zaitldav/AutoGardener/Prototype/Hardware/Gerbers/README - Plan_monitoring_devide_layer_description.txt

Plant_monitoring_device-F.SilkS.gbr                 Top Silk Screen
Plant_monitoring_device-F.Mask.gbr                  Top Solder Mask
Plant_monitoring_device-F.Cu.gbr                    Top Copper
Plant_monitoring_device-B.Cu.gbr                    Bottom Copper
Plant_monitoring_device-B.Mask.gbr                  Bottom Solder Mask
Plant_monitoring_device-B.SilkS.gbr                 Bottom Silk Screen
Plant_monitoring_device-Edge.Cuts.gbr               Board Outline
Plant_monitoring_device-PTH.drl                     Plated Drill
Plant_monitoring_device-NPTH.drl                    Non Plated Drill
