zaitldav/AutoGardener/Box/bottom.obj

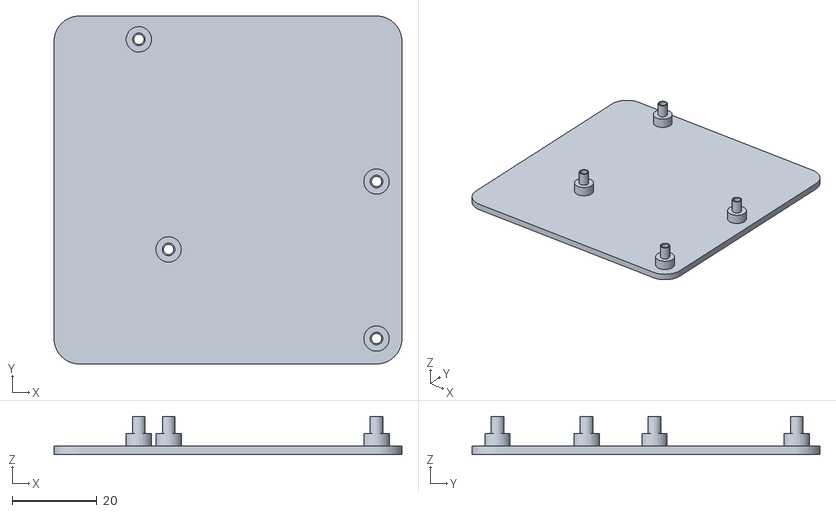
[picture p1: CAD file, 2019-11-17]
Box/bottom.obj
82.0 x 82.0 x 9.00
