zaitldav/AutoGardener/Indoor_Version/Box/Sensor_box.fcstd

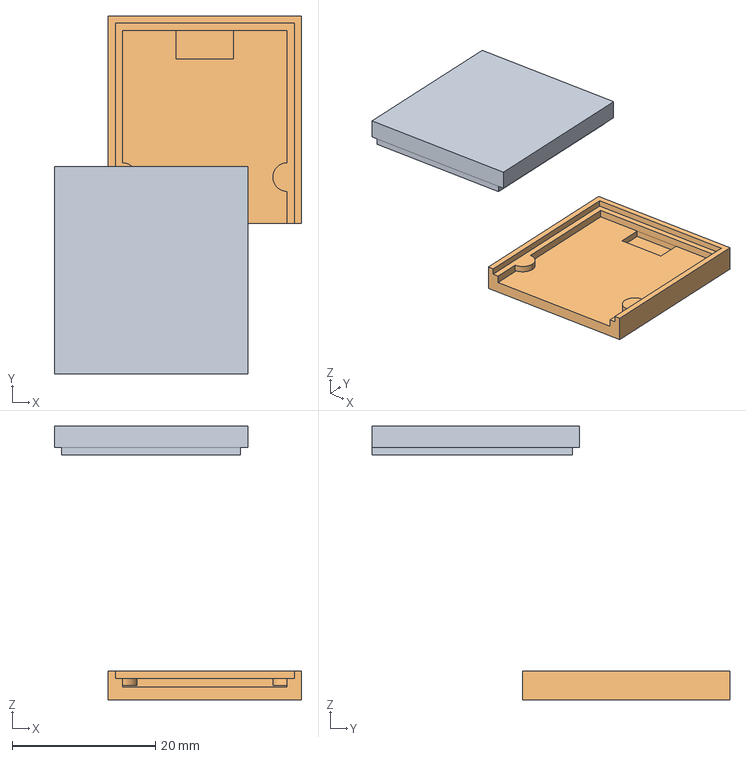
[picture p2: CAD file, 2019-05-28]
Indoor_Version/Box/Sensor_box.fcstd
34.5 x 50.0 x 38.2 mm
Box_top
Box_bot
