zaitldav/AutoGardener/Indoor_Version/Box/STL/Sensor_Box_Bot.stl

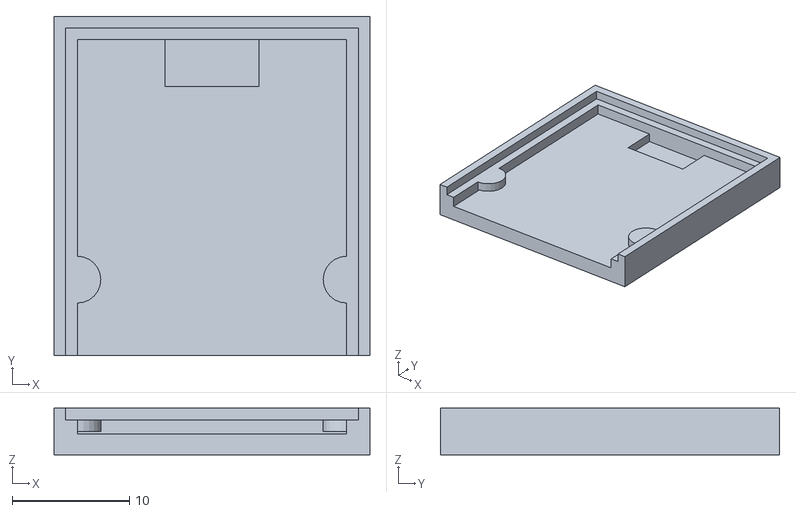
[picture p3: CAD file, 2019-05-28]
Indoor_Version/Box/STL/Sensor_Box_Bot.stl
27.0 x 29.0 x 4.00
