zaitldav/AutoGardener/Indoor_Version/Hardware/Plant_monitoring_device.step

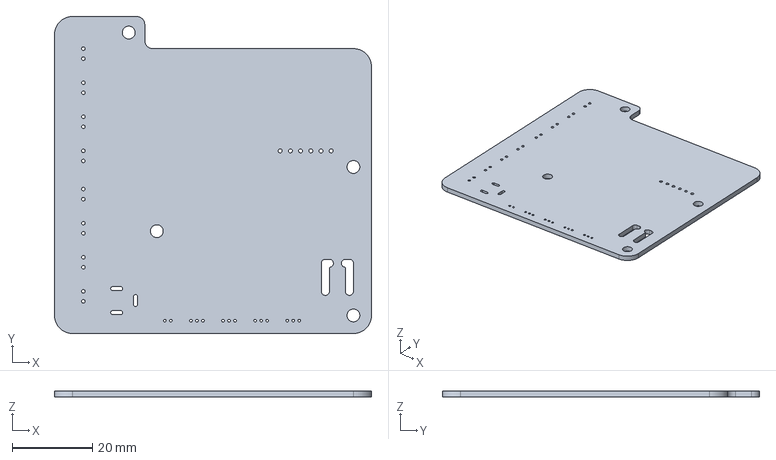
[picture p4: CAD file, 2019-08-13]
Indoor_Version/Hardware/Plant_monitoring_device.step
79.0 x 79.0 x 1.60 mm
