zaitldav/AutoGardener/Box/auto_gardener_top.obj

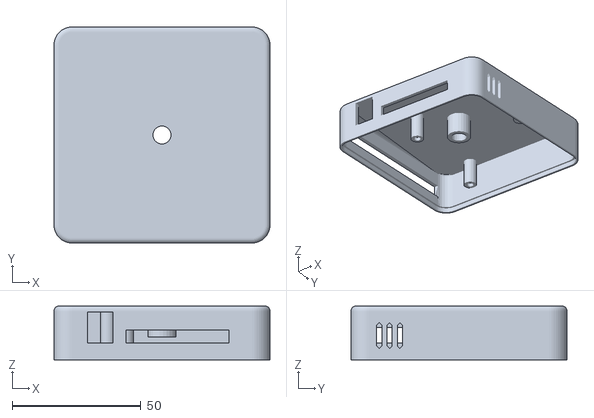
[picture p5: CAD file, 2019-11-17]
Box/auto_gardener_top.obj
84.0 x 84.0 x 21.0
