zaitldav/AutoGardener/Indoor_Version/Box/Box_drawing.dxf

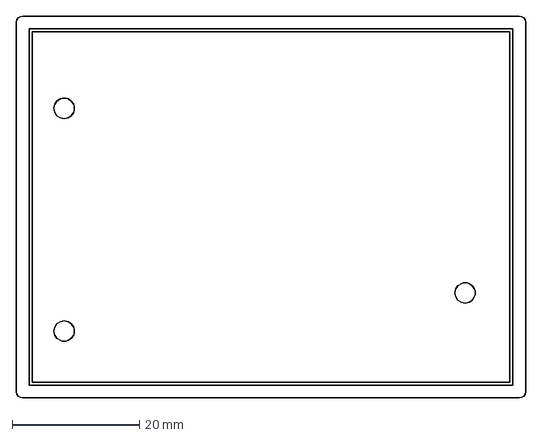
[picture p6: CAD file, 2019-05-14]
Indoor_Version/Box/Box_drawing.dxf
80.0 x 60.0 mm
