zaitldav/AutoGardener/Prototype/Box/Box_v1.fcstd

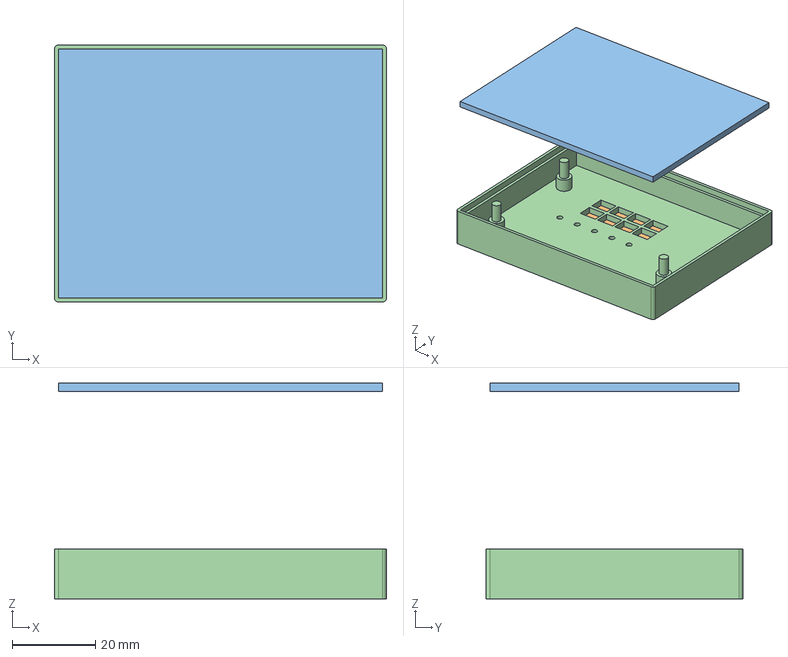
[picture p7: CAD file, 2019-05-14]
Prototype/Box/Box_v1.fcstd
80.0 x 62.0 x 52.0 mm
Inside_Face
Outside_Face
Lid
