zaitldav/AutoGardener/Box/autogardener_box.FCStd

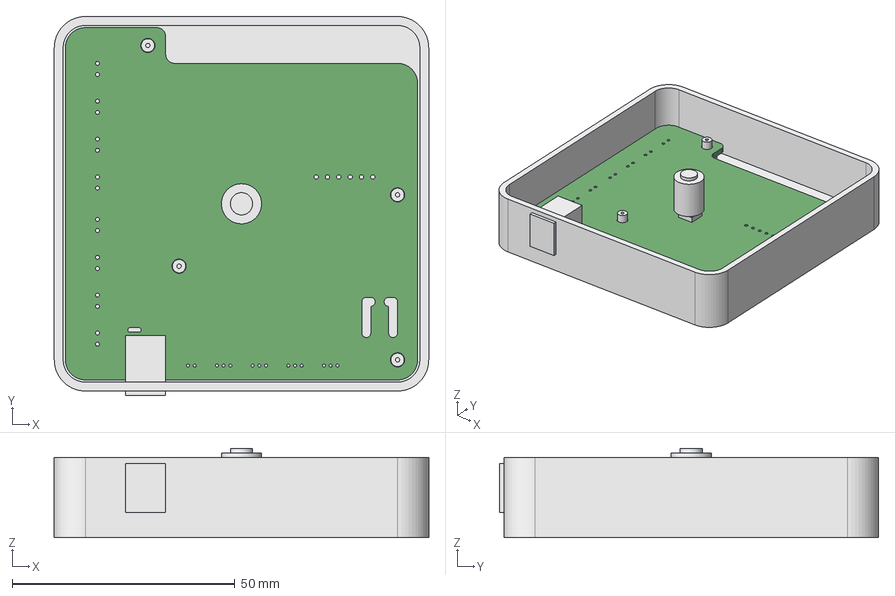
[picture p8: CAD file, 2019-08-13]
Box/autogardener_box.FCStd
84.0 x 85.0 x 20.0 mm
Bottom
Side
Bottom_pillar001
Bottom_pillar002
Bottom_pillar003
Bottom_pillar004
LED_Pilllar_Outside
LED_Pillar_Inside
Power_Connector
