zaitldav/AutoGardener/(list of files, cad)

Other CAD files:
Indoor_Version/Box/STL/Sensor_Box_Top.stl
Outdoor_Version/Box/STL/Sensor_Box_Top.stl
Prototype/Box/STL/Sensor_Box_Top.stl
Box/auto_gardener_bottom.obj
