zaitldav/AutoGardener/(threads)

Thread 1 (2019-04-08):

Select LDO

zaitldav, 2019-04-08:
Select a LDO: Vinmax > 12V, Iout max > 50mA; Iq as low as possible, Price < 20CZK

 * [LD2985BM33R](https://www.tme.eu/cz/details/ld2985bm33r/stabilizatory-napeti-neregulovane-ldo/st-microelectronics/) - Iq = 80-100 uA; I50 = 600-900 uA; 10CZK
 * [**IFX1763XEJV33XUMA1**](https://www.tme.eu/cz/details/ifx1763xejv33/stabilizatory-napeti-neregulovane-ldo/infineon-technologies/ifx1763xejv33xuma1/) - Iq = 30-60 uA; I50 = 300-850 uA; 18CZK
 * [**SPX5205M5-L-3-3/TR**](https://www.tme.eu/cz/details/spx5205m5l3-3tr/stabilizatory-napeti-neregulovane-ldo/exar/spx5205m5-l-3-3-tr/) - Iq = 70-130-100 uA; I50 = 350-800 uA; 7CZK
 * [**AP2204RB-3.3TRG1**](https://www.tme.eu/cz/details/ap2204rb-3.3trg1/stabilizatory-napeti-neregulovane-ldo/diodes-incorporated/)  - Iq = 20-50 uA; I50 = 500 uA; 4.25CZK
 * [MIC5205-3.3YM5-TR](https://www.tme.eu/cz/details/mic5205-3.3ym5-tr/stabilizatory-napeti-neregulovane-ldo/microchip-technology/)  - Iq = 80-150 uA; I50 = 350-800 uA; 12.25CZK

zaitldav, 2019-04-09:
Done - SPX5205M5-L-3-3/TR

Closed 2019-04-09.

Thread 2 (2019-05-28):

Think about future versions

zaitldav, 2019-05-28:
There will be at least two versions in the future:
 * Indoor wired version with LED strips and valves/pumps.
    * How many channels?
    * Use USB communication (STM32) or wifi (ESP32)
    * Add a light sensor.
 * Outdoor battery-powered version with valves only.
    * Use batteries with higher voltage, 3V is not enough for valves. Use at least 3xAA/AAA.
    * LoRa communication?
    * Maybe more versions, the communicating one should measure temperature and humidity.

Closed 2019-07-19.

Thread 3 (2019-05-28):

Select another power connector

zaitldav, 2019-05-28:
Select a power connector for DC power supply which is smaller than the recent one.

The used 5.5/2.5 barrel jack is too high, something 1-2mm shorter than the connectors should be used.

zaitldav, 2019-07-19:
Not needed in this design.

Closed 2019-07-19.
