zaitldav/AutoGardener/Indoor_Version/Hardware/Plant_monitoring_device.kicad_pcb

## KiCad design Indoor_Version/Hardware/Plant_monitoring_device.kicad_pcb (2019-11-17)

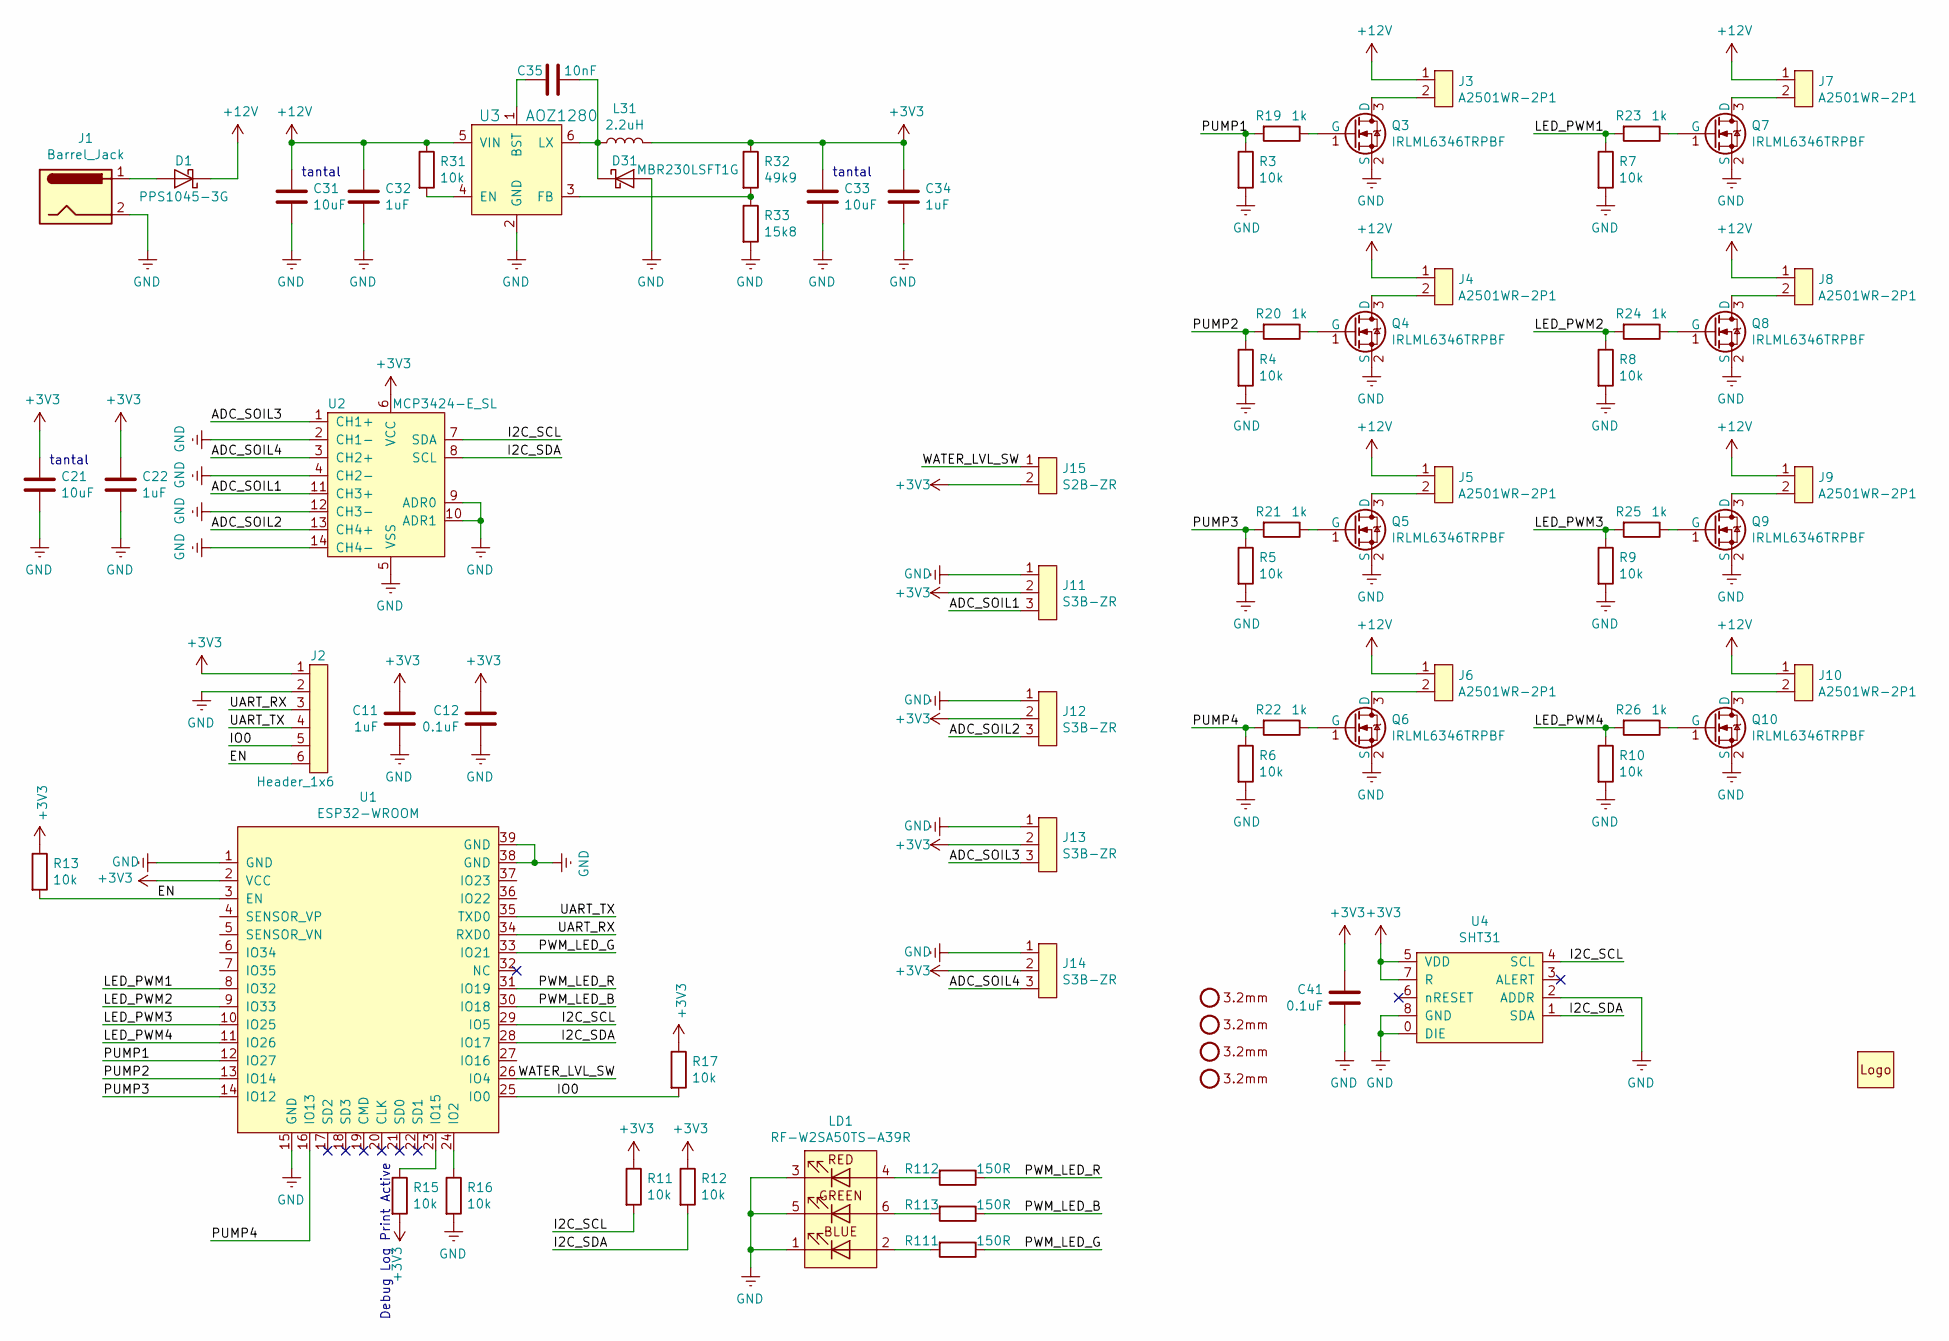
[picture p9: schematic Plant_monitoring_device.sch, Plant Monitoring Device]

Parts:
C11, C22, C32, C34: 1uF; C0603
C12, C41: 0.1uF; C0603
C21, C31, C33: 10uF; C1210
C35: 10nF; C0603
D1: PPS1045-3G; TO-277-3
D31: MBR230LSFT1G; SOD-123
H1, H2, H3, H4: Mounting_hole_unplated_3,2mm
H111: Mr_Gardener_Logo_Small; mrg_gardener_12mm
J1: Barrel_Jack; BarrelJack_Horizontal
J2: Header_1x6; Header_1x06_P2.54mm
J3, J4, J5, J6, J7, J8, J9, J10: A2501WR-2P1
J11, J12, J13, J14: S3B-ZR
J15: S2B-ZR
L31: 2.2uH; L1210
LD1: RF-W2SA50TS-A39R
Q3, Q4, Q5, Q6, Q7, Q8, Q9, Q10: IRLML6346TRPBF; SOT-23
R3, R4, R5, R6, R7, R8, R9, R10, R11, R12, R13, R15, R16, R17, R31: 10k; R0603
R19, R20, R21, R22, R23, R24, R25, R26: 1k; R0603
R32: 49k9; R0603
R33: 15k8; R0603
R111, R112, R113: 150R; R0603
U1: ESP32-WROOM
U2: MCP3424-E_SL; SOIC-14
U3: AOZ1280; SOT-23-6
U4: SHT31

Connections:
+3V3: C11.1, C12.1, C21.1, C22.1, C33.1, C34.1, C41.1, J2.1, J11.2, J12.2, J13.2, J14.2, J15.2, L31.2, R11.1, R12.1, R13.1, R15.2, R17.1, R32.1, U1.2 (VCC), U2.6 (VCC), U4.5 (VDD), U4.7 (R)
+12V: C31.1, C32.1, D1.1 (K), J3.1, J4.1, J5.1, J6.1, J7.1, J8.1, J9.1, J10.1, R31.1, U3.5 (VIN)
/ADC_SOIL1: J11.3, U2.11 (CH3+)
/ADC_SOIL2: J12.3, U2.13 (CH4+)
/ADC_SOIL3: J13.3, U2.1 (CH1+)
/ADC_SOIL4: J14.3, U2.3 (CH2+)
/EN: J2.6, R13.2, U1.3 (EN)
/I2C_SCL: R11.2, U1.29 (IO5), U2.7 (SDA), U4.4 (SCL)
/I2C_SDA: R12.2, U1.28 (IO17), U2.8 (SCL), U4.1 (SDA)
/IO0: J2.5, R17.2, U1.25 (IO0)
/LED_PWM1: R7.1, R23.2, U1.8 (IO32)
/LED_PWM2: R8.1, R24.2, U1.9 (IO33)
/LED_PWM3: R9.1, R25.2, U1.10 (IO25)
/LED_PWM4: R10.1, R26.2, U1.11 (IO26)
/PUMP1: R3.1, R19.2, U1.12 (IO27)
/PUMP2: R4.1, R20.2, U1.13 (IO14)
/PUMP3: R5.1, R21.2, U1.14 (IO12)
/PUMP4: R6.1, R22.2, U1.16 (IO13)
/PWM_LED_B: R113.1, U1.30 (IO18)
/PWM_LED_G: R111.1, U1.33 (IO21)
/PWM_LED_R: R112.1, U1.31 (IO19)
/UART_RX: J2.3, U1.34 (RXD0)
/UART_TX: J2.4, U1.35 (TXD0)
/WATER_LVL_SW: J15.1, U1.26 (IO4)
GND: C11.2, C12.2, C21.2, C22.2, C31.2, C32.2, C33.2, C34.2, C41.2, D31.2 (A), J1.2, J2.2, J11.1, J12.1, J13.1, J14.1, LD1.1 (K), LD1.3 (K), LD1.5 (K), Q3.2 (S), Q4.2 (S), Q5.2 (S), Q6.2 (S), Q7.2 (S), Q8.2 (S), Q9.2 (S), Q10.2 (S), R3.2, R4.2, R5.2, R6.2, R7.2, R8.2, R9.2, R10.2, R16.2, R33.2, U1.1 (GND), U1.15 (GND), U1.38 (GND), U1.39 (GND), U2.2 (CH1-), U2.4 (CH2-), U2.5 (VSS), U2.9 (ADR0), U2.10 (ADR1), U2.12 (CH3-), U2.14 (CH4-), U3.2 (GND), U4.0 (DIE), U4.2 (ADDR), U4.8 (GND)
unnamed: C35.1, U3.1 (BST)
unnamed: C35.2, D31.1 (K), L31.1, U3.6 (LX)
unnamed: D1.2 (A), J1.1
unnamed: J3.2, Q3.3 (D)
unnamed: J4.2, Q4.3 (D)
unnamed: J5.2, Q5.3 (D)
unnamed: J6.2, Q6.3 (D)
unnamed: J7.2, Q7.3 (D)
unnamed: J8.2, Q8.3 (D)
unnamed: J9.2, Q9.3 (D)
unnamed: J10.2, Q10.3 (D)
unnamed: LD1.2 (A), R111.2
unnamed: LD1.4 (A), R112.2
unnamed: LD1.6 (A), R113.2
unnamed: Q3.1 (G), R19.1
unnamed: Q4.1 (G), R20.1
unnamed: Q5.1 (G), R21.1
unnamed: Q6.1 (G), R22.1
unnamed: Q7.1 (G), R23.1
unnamed: Q8.1 (G), R24.1
unnamed: Q9.1 (G), R25.1
unnamed: Q10.1 (G), R26.1
unnamed: R15.1, U1.23 (IO15)
unnamed: R16.1, U1.24 (IO2)
unnamed: R31.2, U3.4 (EN)
unnamed: R32.2, R33.1, U3.3 (FB)

Notes on the sheet:
tantal
Debug Log Print Active

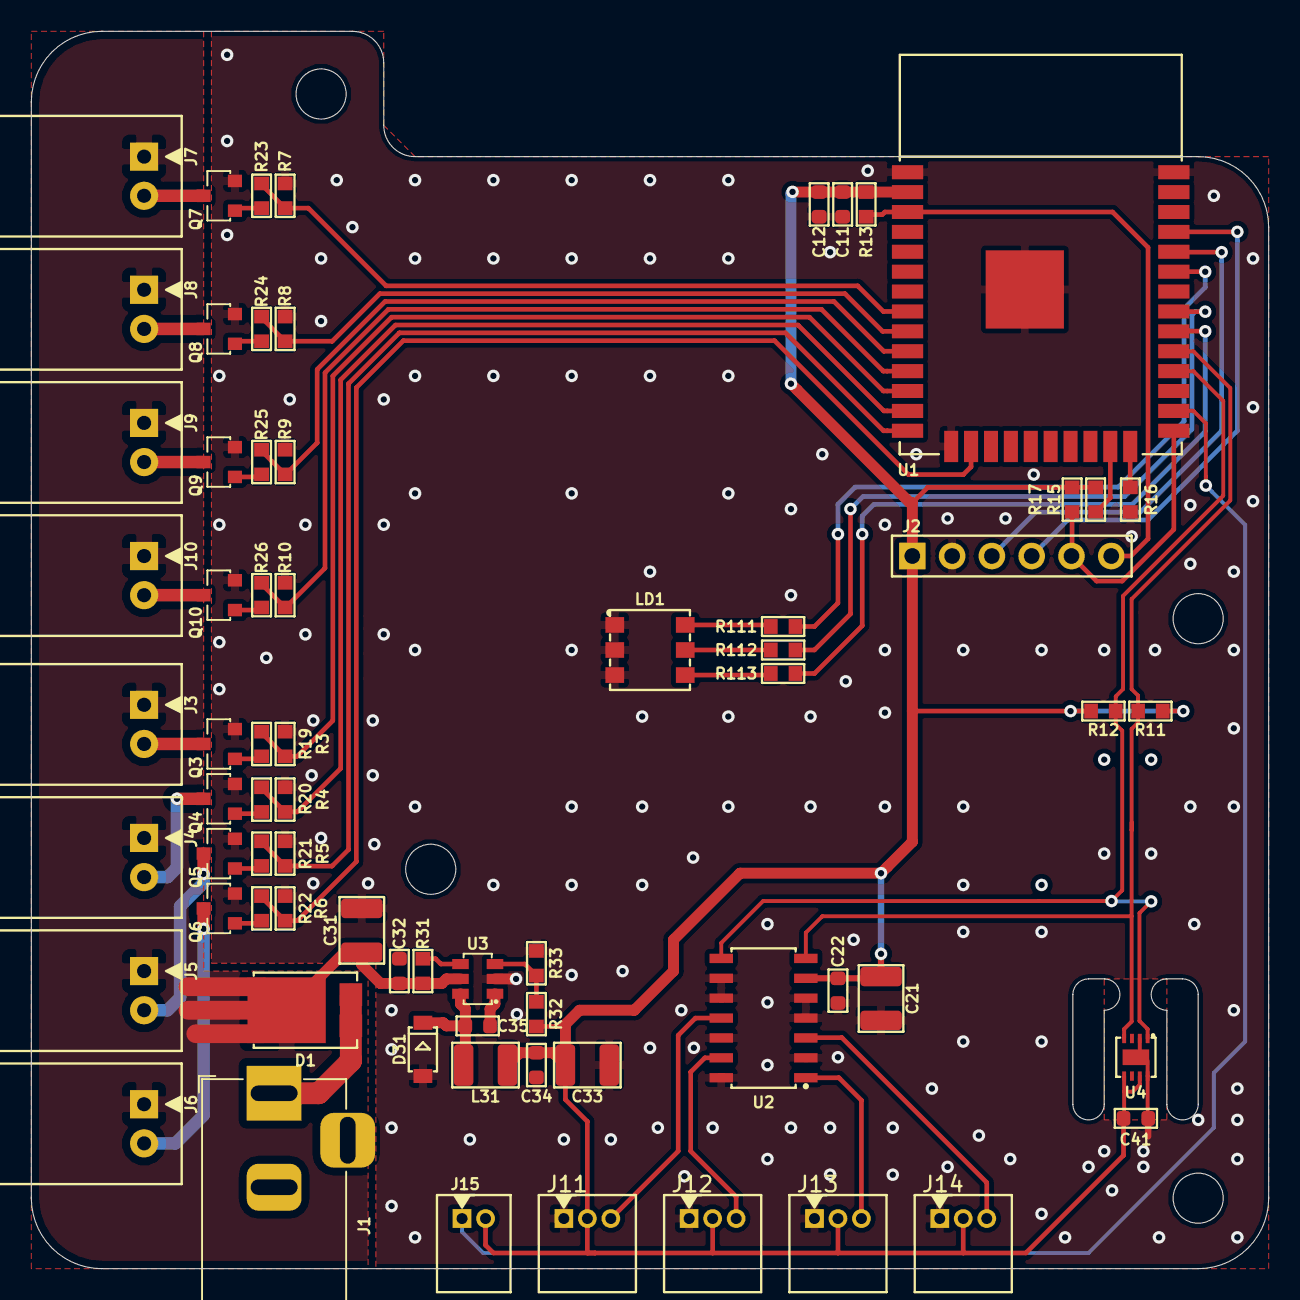
[picture p10: board Indoor_Version/Hardware/Plant_monitoring_device.kicad_pcb from above]

Board: 2 copper layers, 79.0 x 79.0 mm, 74 parts (1 on the bottom side), 51 nets.
