zaitldav/AutoGardener/Outdoor_Version/Hardware/AutoGardener_Outdoor.kicad_pcb

## KiCad design Outdoor_Version/Hardware/AutoGardener_Outdoor.kicad_pcb (2019-08-13)

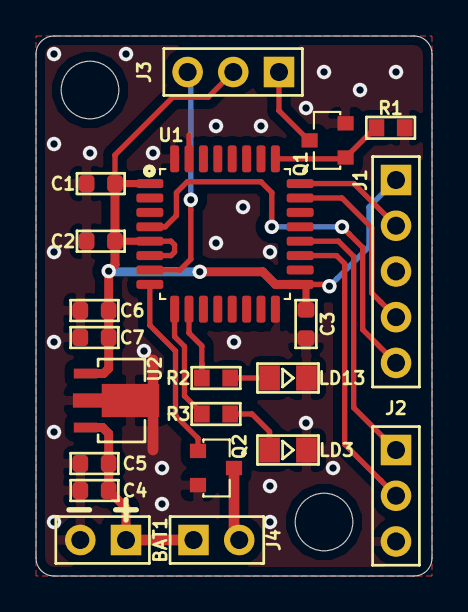
[picture p11: board AutoGardener_Outdoor.kicad_pcb from above]

Board: 2 copper layers, 22.0 x 30.0 mm, 24 parts (1 on the bottom side), 17 nets.

Parts:
BAT1: Battery; Header_1x02_P2.54mm
C1, C5, C7: 1uF; C0603
C2, C3: 0.1uF; C0603
C4, C6: 10uF; C0603
H1, H2: Mounting_hole_unplated_3,2mm
H111: Mr_Gardener_Logo_Small; mrg_gardener_08mm
J1: SWO; Header_1x05_P2.54mm
J2, J3: Header_1x3; Header_1x03_P2.54mm
J4: Header_1x2; Header_1x02_P2.54mm
LD3: ORANGE; LED_0805
LD13: RED; LED_0805
Q1, Q2: 2N7002P.215; SOT-23
R1: 10k; R0603
R2, R3: 1k; R0603
U1: STM32L031K6T6; LQFP-32_7x7mm_P0.8mm
U2: AP2204RB-3.3TRG1; SOT-89

Connections:
+5V: BAT1.1, C4.1, C5.1, J4.1, U2.3
/ADC_SOIL1: J3.3, U1.7
/BAT_LO: R2.1, U1.10
/LED1: R3.1, U1.9
/NRST: J1.5, U1.4
/OUT1: Q2.1, U1.8
/SENS_ENA: Q1.1, R1.1, U1.25
/SWCLK: J1.2, U1.24
/SWDIO: J1.4, U1.23
/UART_RX: J2.1, U1.20
/UART_TX: J2.2, U1.19
GND: BAT1.2, C1.2, C2.2, C3.2, C4.2, C5.2, C6.2, C7.2, J1.3, J2.3, LD3.1, LD13.1, Q1.2, Q2.2, R1.2, U1.16, U1.31, U1.32, U2.2
unnamed: J3.1, Q1.3
unnamed: J4.2, Q2.3
unnamed: LD3.2, R3.2
unnamed: LD13.2, R2.2
VCC: C1.1, C2.1, C3.1, C6.1, C7.1, J1.1, J3.2, U1.1, U1.5, U1.6, U1.17, U2.1
