zaitldav/AutoGardener/Prototype/Hardware/Plant_monitoring_device.kicad_pcb

## KiCad design Prototype/Hardware/Plant_monitoring_device.kicad_pcb (2019-05-14)

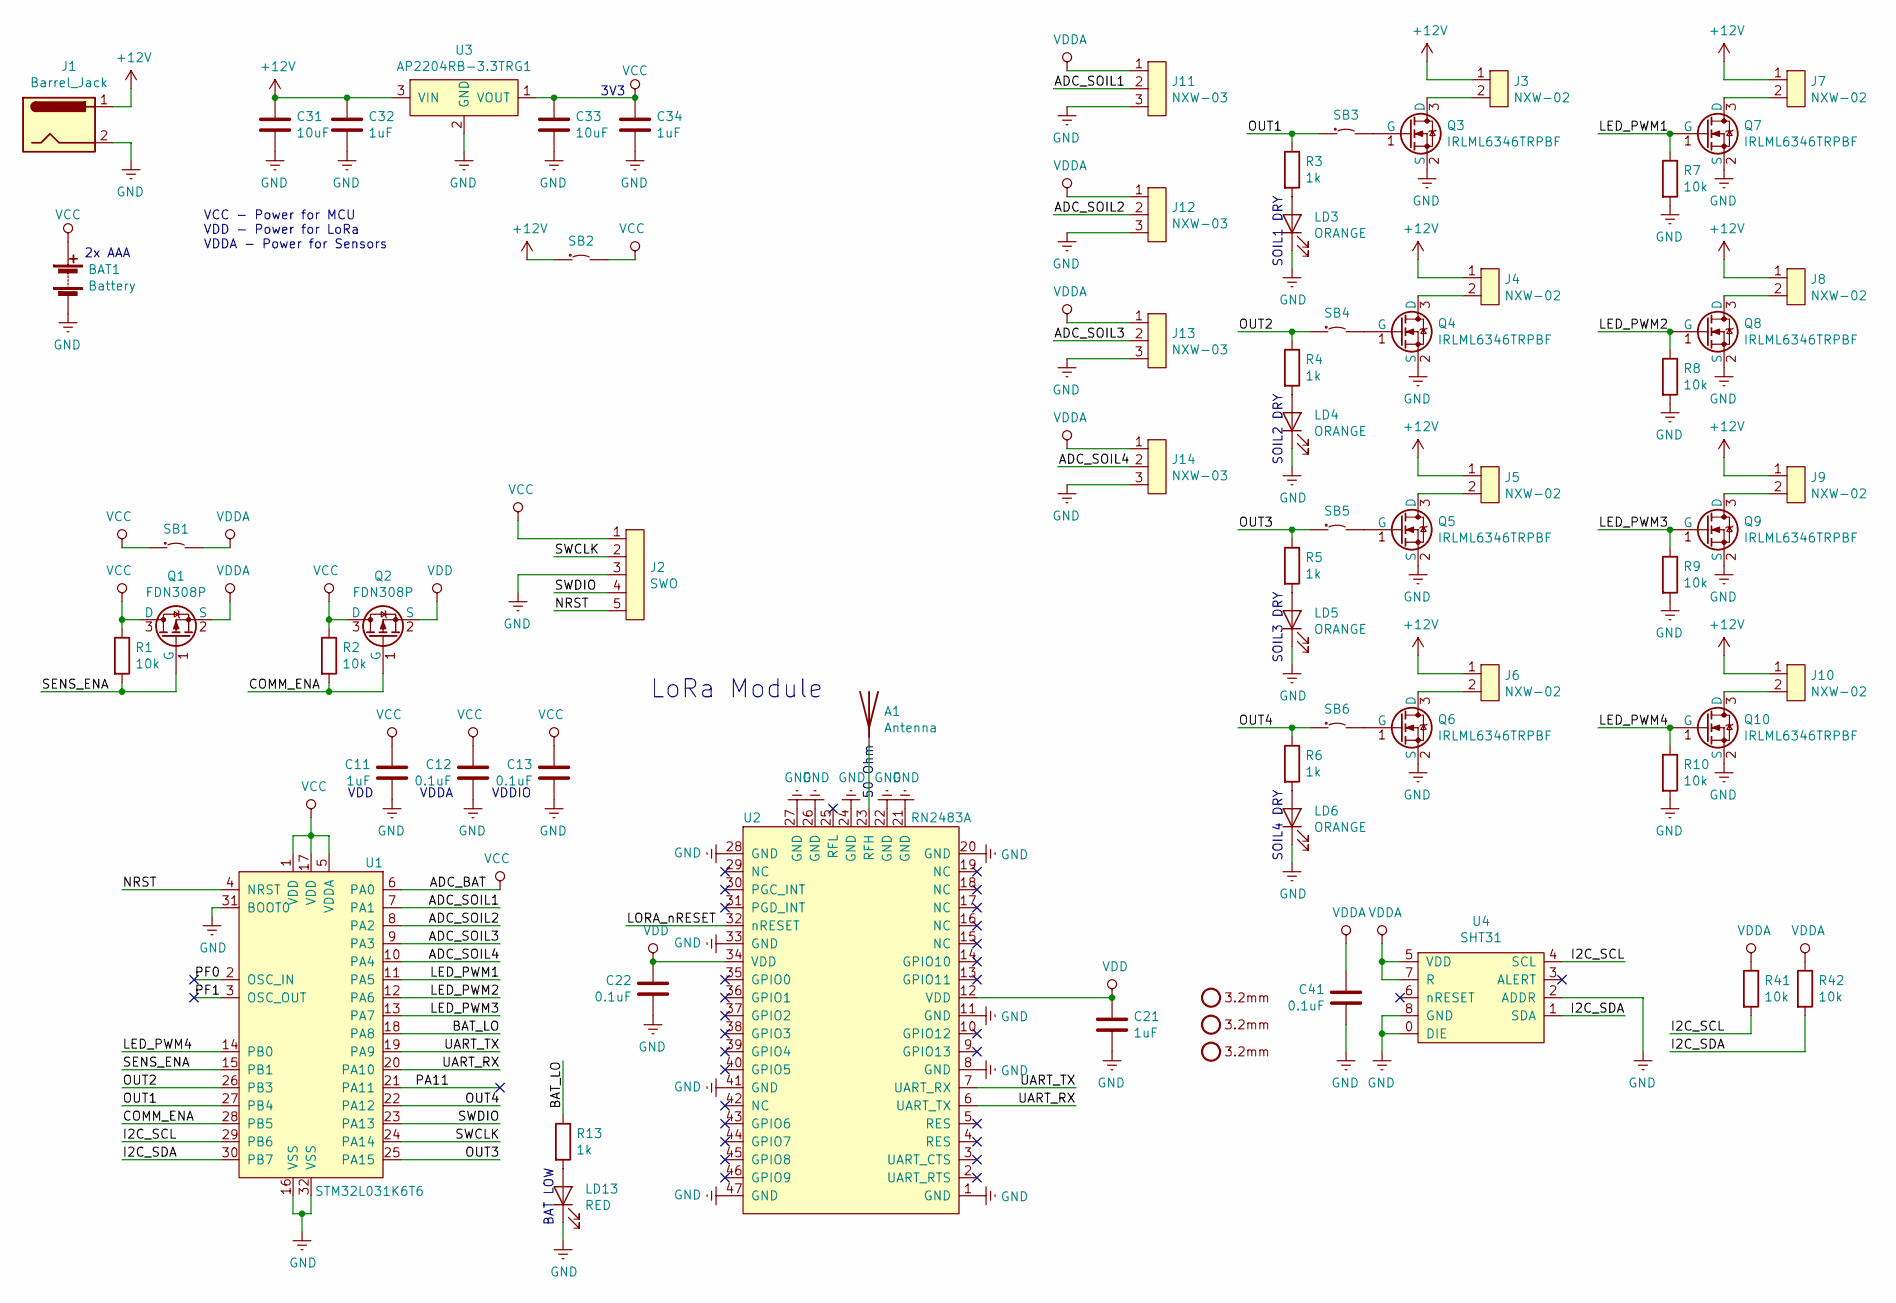
[picture p12: schematic Plant_monitoring_device.sch, Plant Monitoring Device]

Parts:
A1: Antenna; ANT_WIRE_THT
BAT1: Battery; BatteryHolder_Keystone_2468_2xAAA
C11, C21, C32, C34: 1uF; C0603
C12, C13, C22, C41: 0.1uF; C0603
C31, C33: 10uF; C0603
H1, H2, H3: Mounting_hole_unplated_3,2mm
J1: Barrel_Jack; BarrelJack_Horizontal
J2: SWO; Header_1x05_P2.54mm
J3, J4, J5, J6, J7, J8, J9, J10: NXW-02
J11, J12, J13, J14: NXW-03
LD3, LD4, LD5, LD6: ORANGE; LED_0805
LD13: RED; LED_0805
Q1, Q2: FDN308P; SOT-23
Q3, Q4, Q5, Q6, Q7, Q8, Q9, Q10: IRLML6346TRPBF; SOT-23
R1, R2, R7, R8, R9, R10, R41, R42: 10k; R0603
R3, R4, R5, R6, R13: 1k; R0603
SB1, SB2, SB3, SB4, SB5, SB6: SolderBridge; SB0603
U1: STM32L031K6T6; LQFP-32_7x7mm_P0.8mm
U2: RN2483A
U3: AP2204RB-3.3TRG1; SOT-89
U4: SHT31

Connections:
+12V: C31.1, C32.1, J1.1, J3.1, J4.1, J5.1, J6.1, J7.1, J8.1, J9.1, J10.1, SB2.1, U3.3 (VIN)
/ADC_SOIL1: J11.2, U1.7 (PA1)
/ADC_SOIL2: J12.2, U1.8 (PA2)
/ADC_SOIL3: J13.2, U1.9 (PA3)
/ADC_SOIL4: J14.2, U1.10 (PA4)
/BAT_LO: R13.1, U1.18 (PA8)
/COMM_ENA: Q2.1 (G), R2.2, U1.28 (PB5)
/I2C_SCL: R41.2, U1.29 (PB6), U4.4 (SCL)
/I2C_SDA: R42.2, U1.30 (PB7), U4.1 (SDA)
/LED_PWM1: Q7.1 (G), R7.1, U1.11 (PA5)
/LED_PWM2: Q8.1 (G), R8.1, U1.12 (PA6)
/LED_PWM3: Q9.1 (G), R9.1, U1.13 (PA7)
/LED_PWM4: Q10.1 (G), R10.1, U1.14 (PB0)
/LORA_nRESET: U2.32 (nRESET)
/NRST: J2.5, U1.4 (NRST)
/OUT1: R3.1, SB3.1, U1.27 (PB4)
/OUT2: R4.1, SB4.1, U1.26 (PB3)
/OUT3: R5.1, SB5.1, U1.25 (PA15)
/OUT4: R6.1, SB6.1, U1.22 (PA12)
/PA11: U1.21 (PA11)
/PF0: U1.2 (OSC_IN)
/PF1: U1.3 (OSC_OUT)
/SENS_ENA: Q1.1 (G), R1.2, U1.15 (PB1)
/SWCLK: J2.2, U1.24 (PA14)
/SWDIO: J2.4, U1.23 (PA13)
/UART_RX: U1.20 (PA10), U2.6 (UART_TX)
/UART_TX: U1.19 (PA9), U2.7 (UART_RX)
GND: BAT1.2 (-), C11.2, C12.2, C13.2, C21.2, C22.2, C31.2, C32.2, C33.2, C34.2, C41.2, J1.2, J2.3, J11.3, J12.3, J13.3, J14.3, LD3.1 (K), LD4.1 (K), LD5.1 (K), LD6.1 (K), LD13.1 (K), Q3.2 (S), Q4.2 (S), Q5.2 (S), Q6.2 (S), Q7.2 (S), Q8.2 (S), Q9.2 (S), Q10.2 (S), R7.2, R8.2, R9.2, R10.2, U1.16 (VSS), U1.31 (BOOT0), U1.32 (VSS), U2.1 (GND), U2.8 (GND), U2.11 (GND), U2.20 (GND), U2.21 (GND), U2.22 (GND), U2.24 (GND), U2.26 (GND), U2.27 (GND), U2.28 (GND), U2.33 (GND), U2.41 (GND), U2.47 (GND), U3.2 (GND), U4.0 (DIE), U4.2 (ADDR), U4.8 (GND)
unnamed: A1.1, U2.23 (RFH)
unnamed: J3.2, Q3.3 (D)
unnamed: J4.2, Q4.3 (D)
unnamed: J5.2, Q5.3 (D)
unnamed: J6.2, Q6.3 (D)
unnamed: J7.2, Q7.3 (D)
unnamed: J8.2, Q8.3 (D)
unnamed: J9.2, Q9.3 (D)
unnamed: J10.2, Q10.3 (D)
unnamed: LD3.2 (A), R3.2
unnamed: LD4.2 (A), R4.2
unnamed: LD5.2 (A), R5.2
unnamed: LD6.2 (A), R6.2
unnamed: LD13.2 (A), R13.2
unnamed: Q3.1 (G), SB3.2
unnamed: Q4.1 (G), SB4.2
unnamed: Q5.1 (G), SB5.2
unnamed: Q6.1 (G), SB6.2
VCC: BAT1.1 (+), C11.1, C12.1, C13.1, C33.1, C34.1, J2.1, Q1.3 (D), Q2.3 (D), R1.1, R2.1, SB1.1, SB2.2, U1.1 (VDD), U1.5 (VDDA), U1.6 (PA0), U1.17 (VDD), U3.1 (VOUT)
VDD: C21.1, C22.1, Q2.2 (S), U2.12 (VDD), U2.34 (VDD)
VDDA: C41.1, J11.1, J12.1, J13.1, J14.1, Q1.2 (S), R41.1, R42.1, SB1.2, U4.5 (VDD), U4.7 (R)

Notes on the sheet:
SOIL1 DRY
SOIL2 DRY
SOIL3 DRY
SOIL4 DRY
BAT LOW
LoRa Module
VDD
VDDA
VDDIO
3V3
2x AAA
50 Ohm
VCC - Power for MCU VDD - Power for LoRa VDDA - Power for Sensors

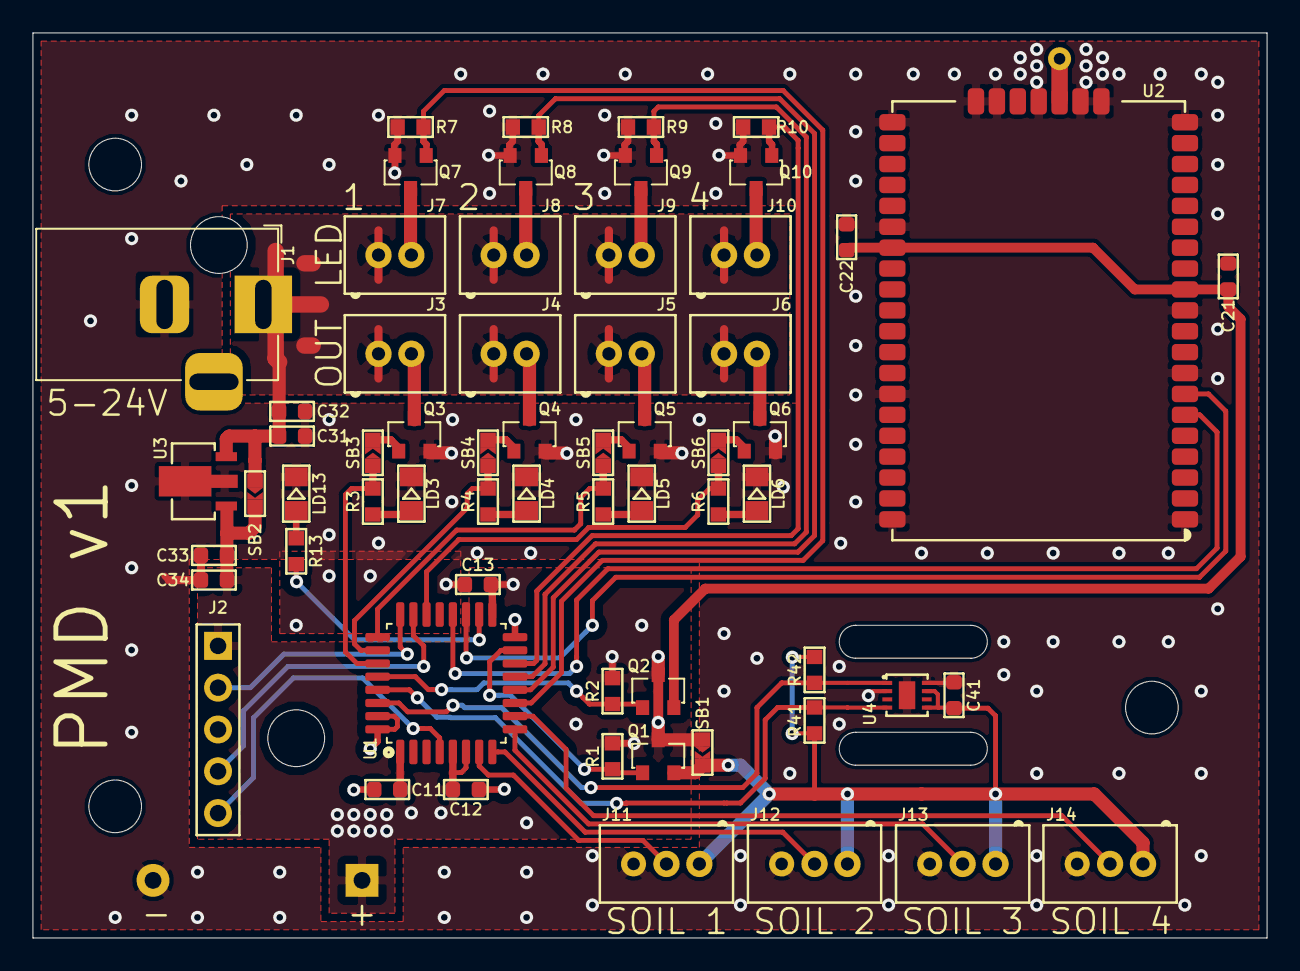
[picture p13: board Prototype/Hardware/Plant_monitoring_device.kicad_pcb from above]

Board: 2 copper layers, 75.0 x 55.0 mm, 67 parts (1 on the bottom side), 45 nets.
