zaitldav/AutoGardener/Outdoor_Version/Firmware/Src/main.c

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

/* Includes ------------------------------------------------------------------*/
#include "main.h"

/* USER CODE BEGIN Includes */
#include <stdbool.h>
/* USER CODE END Includes */

/* USER CODE BEGIN PD */
#define VREFINT_ADDR 0x1FF80078
#define VDD	3300

#define SOIL_THRESHOLD_MV 	1200	// Dry soil is cca 2V
								 	// Watering threshold is cca 1.8V
									// Wet soil is cca 0.6V

#define WATERING_TIME_MS 	5000	// water 5 seconds
#define SLEEP_TIME_MS 		900000	// once per 15 minutes
/* USER CODE END PD */

ADC_HandleTypeDef hadc;

LPTIM_HandleTypeDef hlptim1;

UART_HandleTypeDef huart2;

/* USER CODE BEGIN PV */
uint32_t r_single_int_channel_ADC(uint32_t channel);
void config_int_channel_ADC(uint32_t channel, uint8_t val);
uint32_t r_single_ext_channel_ADC(uint32_t channel);
void config_ext_channel_ADC(uint32_t channel, uint8_t val);
/* USER CODE END PV */

void SystemClock_Config(void);
static void MX_GPIO_Init(void);
static void MX_ADC_Init(void);
static void MX_USART2_UART_Init(void);
static void MX_LPTIM1_Init(void);
/**
  * @brief  The application entry point.
  * @retval int
  */
int main(void)
{
  /* USER CODE BEGIN 1 */
	uint16_t vrefint_cal= *((uint16_t*)VREFINT_ADDR);
  /* USER CODE END 1 */
  

  /* MCU Configuration--------------------------------------------------------*/

  /* Reset of all peripherals, Initializes the Flash interface and the Systick. */
  HAL_Init();

  /* Configure the system clock */
  SystemClock_Config();

  /* Initialize all configured peripherals */
  MX_GPIO_Init();
  MX_ADC_Init();
  MX_USART2_UART_Init();
  MX_LPTIM1_Init();
  /* USER CODE BEGIN 2 */

  HAL_GPIO_WritePin(BAT_LO_GPIO_Port, BAT_LO_Pin, 1);

	HAL_GPIO_WritePin(SENS_ENA_GPIO_Port, SENS_ENA_Pin, 0);
  /* USER CODE END 2 */

  /* Infinite loop */
  /* USER CODE BEGIN WHILE */
  while (1)
  {


	  uint16_t vbat_adc = r_single_ext_channel_ADC(ADC_CHANNEL_0);
	  uint16_t soil1_adc = r_single_ext_channel_ADC(ADC_CHANNEL_1);
	  uint16_t soil2_adc = r_single_ext_channel_ADC(ADC_CHANNEL_2);
	  uint16_t soil3_adc = r_single_ext_channel_ADC(ADC_CHANNEL_3);
	  uint16_t soil4_adc = r_single_ext_channel_ADC(ADC_CHANNEL_4);
	  uint16_t vrefint_adc = r_single_int_channel_ADC(ADC_CHANNEL_VREFINT);

	  uint16_t vdd_real = VDD*vrefint_cal/vrefint_adc;

	  uint16_t vbat = vdd_real*vbat_adc/4095;
	  uint16_t soil1 = vdd_real*soil1_adc/4095;
	  uint16_t soil2 = vdd_real*soil2_adc/4095;
	  uint16_t soil3 = vdd_real*soil3_adc/4095;
	  uint16_t soil4 = vdd_real*soil4_adc/4095;

	  /*if (soil1 >= 2000)
	  {
			HAL_GPIO_WritePin(OUT1_GPIO_Port, OUT1_Pin, GPIO_PIN_SET);
	  } else
	  {

			HAL_GPIO_WritePin(OUT1_GPIO_Port, OUT1_Pin, GPIO_PIN_RESET);
	  }*/

	  HAL_GPIO_WritePin(OUT1_GPIO_Port, OUT1_Pin, soil1 >= SOIL_THRESHOLD_MV);
	  HAL_GPIO_WritePin(OUT2_GPIO_Port, OUT2_Pin, soil2 >= SOIL_THRESHOLD_MV);
	  HAL_GPIO_WritePin(OUT3_GPIO_Port, OUT3_Pin, soil3 >= SOIL_THRESHOLD_MV);
	  HAL_GPIO_WritePin(OUT4_GPIO_Port, OUT4_Pin, soil4 >= SOIL_THRESHOLD_MV);

	  HAL_Delay(WATERING_TIME_MS);

	  HAL_GPIO_WritePin(OUT1_GPIO_Port, OUT1_Pin, 0);
	  HAL_GPIO_WritePin(OUT2_GPIO_Port, OUT2_Pin, 0);
	  HAL_GPIO_WritePin(OUT3_GPIO_Port, OUT3_Pin, 0);
	  HAL_GPIO_WritePin(OUT4_GPIO_Port, OUT4_Pin, 0);

	  HAL_Delay(SLEEP_TIME_MS);
    /* USER CODE END WHILE */

    /* USER CODE BEGIN 3 */
  }
  /* USER CODE END 3 */
}

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
/* USER CODE BEGIN 4 */
void config_int_channel_ADC(uint32_t channel, uint8_t val)
{
  ADC_ChannelConfTypeDef sConfig;
  sConfig.Channel = channel;

  if(val == 1)
  {
    if(channel == ADC_CHANNEL_VREFINT)
    {
      ADC->CCR |= ADC_CCR_VREFEN;
      hadc.Instance->CHSELR = (uint32_t)(ADC_CHSELR_CHSEL17);
    }
    else if(channel == ADC_CHANNEL_TEMPSENSOR)
    {
      ADC->CCR |= ADC_CCR_TSEN;
      hadc.Instance->CHSELR = (uint32_t)(ADC_CHSELR_CHSEL6);
    }

    sConfig.Rank          = ADC_RANK_CHANNEL_NUMBER;
  }
  else if(val == 0)
  {
    if(channel == ADC_CHANNEL_VREFINT)
    {
      ADC->CCR &= ~ADC_CCR_VREFEN;
      hadc.Instance->CHSELR = 0;
    }
    else if(channel == ADC_CHANNEL_TEMPSENSOR)
    {
      ADC->CCR &= ~ADC_CCR_TSEN;
      hadc.Instance->CHSELR = 0;
    }

    sConfig.Rank          = ADC_RANK_NONE;
  }

  HAL_ADC_ConfigChannel(&hadc,&sConfig);
}

uint32_t r_single_int_channel_ADC(uint32_t channel)
{
  uint32_t digital_result;

  config_int_channel_ADC(channel, 1);


  HAL_ADC_Start(&hadc);
  HAL_ADC_PollForConversion(&hadc, 1000);
  digital_result = HAL_ADC_GetValue(&hadc);
  HAL_ADC_Stop(&hadc);

  config_int_channel_ADC(channel, 0);

  return digital_result;
}

void config_ext_channel_ADC(uint32_t channel, uint8_t val)
{
  ADC_ChannelConfTypeDef sConfig;

  sConfig.Channel = channel;

  if(1 == val)
  {
    sConfig.Rank = ADC_RANK_CHANNEL_NUMBER;
  }
  else
  {
    sConfig.Rank = ADC_RANK_NONE;
  }

  HAL_ADC_ConfigChannel(&hadc, &sConfig);
}

uint32_t r_single_ext_channel_ADC(uint32_t channel)
{
  uint32_t digital_result;

  config_ext_channel_ADC(channel, 1);


  HAL_ADC_Start(&hadc);
  HAL_ADC_PollForConversion(&hadc, 1000);
  digital_result = HAL_ADC_GetValue(&hadc);
  HAL_ADC_Stop(&hadc);

  config_ext_channel_ADC(channel, 0);

  return digital_result;
}
/* USER CODE END 4 */
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
