zaitldav/AutoGardener/(commit log)

2019-04-08 Initial commit with KiCAD files.
    [Plant_monitoring_device.kicad_pcb, Plant_monitoring_device.sch]
2019-04-08 Changes Step-down for LDO.
    [Plant_monitoring_device.kicad_pcb, Plant_monitoring_device.sch]
2019-04-10 Changes 2.54mm headers for 2mm connectors. Added a solderbridge to connect external supply with the mcu suply (so the outpust and pwms coul be used when the device is powered by a battery. Changed la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
    [Plant_monitoring_device-B.Cu.gbr, Plant_monitoring_device-B.Mask.gbr, Plant_monitoring_device-B.Paste.gbr, Plant_monitoring_device-B.SilkS.gbr, Plant_monitoring_device-Edge.Cuts.gbr, Plant_monitoring_device-F.Cu.gbr, Plant_monitoring_device-F.Mask.gbr, Plant_monitoring_device-F.Paste.gbr]
2019-04-11 Swapped some pins to optmize track to tranzistors. Generated Gerbers.
    [Plant_monitoring_device-B.Cu.gbr, Plant_monitoring_device-B.Mask.gbr, Plant_monitoring_device-B.Paste.gbr, Plant_monitoring_device-B.SilkS.gbr, Plant_monitoring_device-Edge.Cuts.gbr, Plant_monitoring_device-F.Cu.gbr, Plant_monitoring_device-F.Mask.gbr, Plant_monitoring_device-F.Paste.gbr]
2019-04-11 Generated gerbers and created layer description.
    [Plant_monitoring_device-B.Cu.gbr, Plant_monitoring_device-B.Mask.gbr, Plant_monitoring_device-B.Paste.gbr, Plant_monitoring_device-B.SilkS.gbr, Plant_monitoring_device-Edge.Cuts.gbr, Plant_monitoring_device-F.Cu.gbr, Plant_monitoring_device-F.Mask.gbr, Plant_monitoring_device-F.Paste.gbr]
2019-04-11 Added dimensions.
    [Plant_monitoring_device.kicad_pcb]
2019-04-11 Added missing TME Symbols. Generated BOM.
    [Plant_monitoring_device.csv, Plant_monitoring_device.sch]
2019-05-14 Connected BOOT0 pin with GND.
    [Plant_monitoring_device.kicad_pcb, Plant_monitoring_device.sch]
2019-05-14 Created Project using STM32CubeIDE.
2019-05-14 Created Enclosure Prototype.
    [Box_drawing.dxf, Box_v1.fcstd]
2019-05-28 Created a box for the moisture sensor.
    [Sensor_Box_Bot.stl, Sensor_Box_Top.stl, Sensor_box.fcstd]
2019-05-28 Edited the box a bit after the first 3D print.
    [Sensor_Box_Bot.stl, Sensor_Box_Top.stl, Sensor_box.fcstd]
2019-06-06 Moved existing files to a new folder Prototype. Copied these files to separate folders for indoor and outdoor version
    [Box_drawing.dxf, Box_v1.fcstd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]
2019-06-06 Edited the schematic to fit the outdoor one valve, one sensor application. Started routing the PCB.
    [AutoGardener_Outdoor.csv, AutoGardener_Outdoor.kicad_pcb, AutoGardener_Outdoor.sch, Plant_monitoring_device.kicad_pcb, Plant_monitoring_device.sch]
2019-07-09 Small changes on the prototype firmware.
2019-07-09 Generated the STM32 firmware project.
2019-07-09 Started a new kicad project.
    [AutoGardener_Outdoor.kicad_pcb, AutoGardener_Outdoor.sch]
2019-07-09 Replaced STM32 with ESP32. Deleted the PCB.
    [Plant_monitoring_device.kicad_pcb, Plant_monitoring_device.sch]
2019-07-10 Created outline of the PCB and basic layout of connectors. Created schematic and PCB layout of the buck convertor.
    [Plant_monitoring_device.kicad_pcb, Plant_monitoring_device.sch]
2019-07-19 Finished design of the indoor version of the gardener. Generated gerbers.
    [Plant_monitoring_device-B.Cu.gbr, Plant_monitoring_device-B.Mask.gbr, Plant_monitoring_device-B.Paste.gbr, Plant_monitoring_device-B.SilkS.gbr, Plant_monitoring_device-Edge.Cuts.gbr, Plant_monitoring_device-F.Cu.gbr, Plant_monitoring_device-F.Mask.gbr, Plant_monitoring_device-F.Paste.gbr]
2019-07-19 Finished the design of the outdoor version of the gardener. Generated Gerbers.
    [AutoGardener_Outdoor-B.Cu.gbr, AutoGardener_Outdoor-B.Mask.gbr, AutoGardener_Outdoor-B.Paste.gbr, AutoGardener_Outdoor-B.SilkS.gbr, AutoGardener_Outdoor-Edge.Cuts.gbr, AutoGardener_Outdoor-F.Cu.gbr, AutoGardener_Outdoor-F.Mask.gbr, AutoGardener_Outdoor-F.Paste.gbr]
2019-08-12 Added some mechanical details into the PCB document.
    [AutoGardener_Outdoor-B.Cu.gbr, AutoGardener_Outdoor-B.Mask.gbr, AutoGardener_Outdoor-B.Paste.gbr, AutoGardener_Outdoor-B.SilkS.gbr, AutoGardener_Outdoor-Edge.Cuts.gbr, AutoGardener_Outdoor-F.Cu.gbr, AutoGardener_Outdoor-F.Mask.gbr, AutoGardener_Outdoor-F.Paste.gbr]
2019-08-12 Minor changes.
    [Plant_monitoring_device.kicad_pcb, Plant_monitoring_device.sch, Plant_monitoring_device.step]
2019-08-12 Started to work on the box design.
    [autogardener_box.FCStd]
2019-11-17 Added holes for connector in the box.
    [auto_gardener_bottom.obj, auto_gardener_top.obj, bottom.obj]
2019-11-17 Cache save.
    [Plant_monitoring_device.kicad_pcb]
2019-11-17 Deleted files for STM32 and created a project for ESP32 using Platformio.
2019-11-17 Generated BOM.
    [AutoGardener_Outdoor-print.csv]
