zaitldav/AutoGardener/(notices)

Notices in the files:
Prototype/Firmware/Inc/main.h:
© Copyright (c) 2019 STMicroelectronics.
All rights reserved.
This software component is licensed by ST under BSD 3-Clause license,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
(C) COPYRIGHT STMicroelectronics *****END OF FILE
